ph-jordan/nima-tech/Configuração inicial da placa.pdf

## Guia de Configuração da Balança (ESP32)

Este procedimento deve ser realizado na primeira vez que a balança for ligada ou sempre que houver mudança na rede Wi-Fi ou no servidor MQTT.

### 1. Entrando no Modo de Configuração

Ao ligar a balança na energia, o sistema tentará conectar à última rede Wi-Fi salva. Se não conseguir conectar (ou se for a primeira vez), ela entrará automaticamente no Modo Seguro.

Verifique os displays LCD da balança. Se ela estiver aguardando configuração, aparecerá:

- LCD Principal: MODO SEGURO / WiFi: ESP-PESO
- LCD Secundário: Senha: Admin1234 / IP: 192.168.4.1

### 2. Conexão com o Dispositivo

O ESP32 criou uma rede Wi-Fi temporária para que você possa configurá-lo.

1. Pegue seu celular ou computador.
2. Abra as configurações de Wi-Fi.
3. Procure pela rede chamada: ESP32-Pesagem
4. Conecte-se a ela usando a senha: Admin1234

### 3. Acessando o Portal

Geralmente, assim que conectar, uma tela de login abrirá automaticamente (Captive Portal).

- Se a tela não abrir: Abra seu navegador (Chrome, Safari) e digite o endereço: 192.168.4.1

### 4. Configuração da Rede Wi-Fi

Na tela principal do portal:

1. Toque no botão "Configure WiFi".
2. Aguarde o escaneamento das redes.
3. Toque no nome da sua rede Wi-Fi (da empresa ou local de instalação).
4. No campo "Password" (logo no topo), digite a senha do seu Wi-Fi.

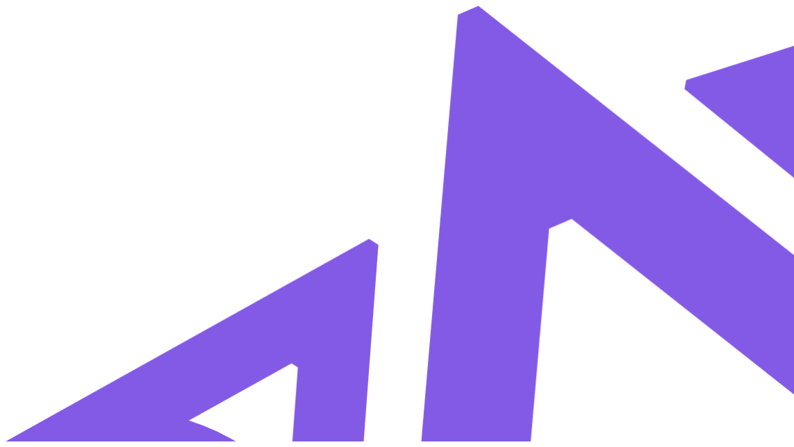
[picture p1: figure]

### 5. Configuração dos Parâmetros do Sistema

Abaixo dos campos de Wi-Fi, você verá os campos personalizados definidos no código. Preencha-os com atenção:

- Nome Bancada: Identificador local da balança (ex: Bancada_01, Setor_A). Isso será usado para identificar de onde vêm os dados.
- MQTT Broker: Endereço do servidor (6df66d562a2e4bbdb0555f70df83a04d.s1.eu.hivemq.cloud).
- MQTT Port: Porta do servidor (Padrão: 8883)
- MQTT User: Usuário de autenticação do broker. (Cliente)
- MQTT Pass: Senha do broker.(Placateste1).

### 6. Salvar e Finalizar

1. Revise se a senha do Wi-Fi e os dados do servidor estão corretos.
2. Clique no botão "Save".
3. A balança irá reiniciar automaticamente.
- Observe o LCD Principal: Ele deve mudar de "MODO SEGURO" para "INICIANDO..." e depois para o status de operação (ex: "Aguarde Cartão" ou "MQTT Conectado").
