ph-jordan/nima-tech/Empresas para realizarem outros serviços.pdf

### EMPRESAS PARA SERVIDOR BROKER:

- HiveMQ cloud;
- EMQX;
- MyQttHub;
- CloudMQTT;
- TagoIO;
- Ubidots;
- Big Tech;

### EMPRESAS QUE REALIZAM A MANUFATURA DA PLACA:

- Enterplak: https://enterplak.com.br/negocio/
- Mensagem da Enterplak: “Para garantirmos custos competitivos e repassarmos esses benefícios em nossas propostas comerciais, estabelecemos um faturamento mínimo de R$ 120.000,00 por pedido. Trabalhamos com pedidos menores, entre R$ 50.000,00 e R$ 120.000,00, porém com custos adicionais de setup.”
- Griffus:
https://www.griffuspcb.com.br/fabricacao-de-placas-de-circuito-impresso.html
- Global Eletronics: https://globaleletronics.ind.br/servicos/
- Cromatek:https://cromatek.com.br/montagem-de-placas-eletronicas/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 (https://cromatek.com.br/montagem-de-placas-eletronicas/?gad_source=1)
- Produza: https://produza.ind.br/
