ph-jordan/nima-tech/Lista de Materiais da placa com quantidade.odt

- ESP32 (com Wi-Fi e Bluetooth integrado) - modelo DEVKITC: QTD: 1 https://www.eletrogate.com/modulo-wifi-esp32-bluetooth-30-pinos
- Módulo Leitor de Cartões RFID – RC522: QTD: 1 https://www.eletrogate.com/kit-modulo-rfid-mfrc522-1356-mhz
- Conector placa/balança - Saída VGA – Max3232: QTD: 1 https://www.eletrogate.com/conversor-serial-rs232-ttl-max3232
- Botão - CHAVE BOTÃO S/TRAVA 2P: QTD: 5 https://www.saravati.com.br/botao-push-button-250vac-1a-2t-ds-213-sem-trava-preto.html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
- Telas - Display (LCD 16x2) I2C: QTD: 2 https://www.eletrogate.com/display-lcd-16x2-i2c-backlight-azul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
- Resistor 10K - 10 unidades: QTD: 5 https://www.eletrogate.com/resistor-10k-1-4w-10-unidades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
- Resistor 4.7K - 10 unidades: QTD: 2
  https://www.eletrogate.com/resistor-4k7-1-4w-10-unidades
- Resistor 5.1K - 10 unidades: QTD: 2 https://www.eletrogate.com/resistor-5k1-1-4w-10-unidades
- Resistor 330Ω - 10 unidades: QTD: 2 https://www.eletrogate.com/resistor-330r-1-4w-10-unidades
- Capacitor 0.1uF: QTD: 1 https://www.eletrogate.com/capacitor-eletrolitico-1uf-x-50v
- Capacitor Electrolítico SMD 10uF/25V: QTD: 1 https://www.eletrogate.com/capacitor-eletrolitico-10uf-x-50v
- Módulo regulador de tensão tipo C – GT-USB-7010ASV: QTD: 1
  https://pt.aliexpress.com/item/1005007205562231.html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,scm-url:1007.40050.354490.0,pvid:b62a1681-c8ce-4411-b673-8dc0f587e754,tpp_buckets:668%232846%238111%231996&isseo=y&pdp_ext_f=%7B%22order%22%3A%222%22%2C%22eval%22%3A%221%22%2C%22sceneId%22%3A%2230050%22%2C%22fromPage%22%3A%22recommend%22%7D&pdp_npi=6%40dis%21BRL%212.59%212.46%21%21%213.19%213.03%21%402101e80f17648797563131982e8ef2%2112000039798651333%21rec%21BR%21%21ABX%211%210%21n_tag%3A-29910%3Bd%3A8ee5d72e%3Bm03_new_user%3A-29895&utparam-url=scene%3ApcDetailTopMoreOtherSeller%7Cquery_from%3A%7Cx_object_id%3A1005007205562231%7C_p_origin_prod%3A
- Diodo tvs - modelo “TT0521SB”: QTD: 1 https://www.acheicomponentes.com.br/diodo/kit-5-pecas-diodo-tt0521sb-smd-sod-882-5v-40a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
- Led verde – 3mm: QTD: 1 https://www.eletrogate.com/led-difuso-3mm-verde
- Led vermelho – 3mm: QTD: 1 https://www.eletrogate.com/led-difuso-3mm-vermelho
