ph-jordan/nima-tech/Lista de Materiais.pdf

- ESP32 (com Wi-Fi e Bluetooth integrado) - modelo DEVKITC: https://pt.aliexpress.com/item/1005006651936701.html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,scm-url :1007.40196.366991.0,pvid:86ee71ca-66aa-47d0-9b59-c49c89f24ca9,tpp_buckets:668 %232846%238116%232002&pdp_ext_f=%7B%22order%22%3A%22409%22%2C%22e val%22%3A%221%22%2C%22sceneId%22%3A%2230050%22%7D&pdp_npi=4%40di s%21BRL%2127.27%2117.27%21%21%214.50%212.85%21%402101c8021741474912 8488895e673c%2112000037929819276%21rec%21BR%21%21ABXZ&utparam-url=sc ene%3ApcDetailTopMoreOtherSeller%7Cquery_from%3A (https://pt.aliexpress.com/item/1005006651936701.html?scm_id=1007.40196.366991.0&scm-url=1007.40196.366991.0)
- Botão - CHAVE BOTÃO S/TRAVA 2P: https://www.saravati.com.br/botao-push-button-250vac-1a-2t-ds-213-sem-trava-preto.html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 cB (https://www.saravati.com.br/botao-push-button-250vac-1a-2t-ds-213-sem-trava-preto.html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)
- Módulo Leitor de Cartões RFID - RC522: https://produto.mercadolivre.com.br/MLB-814816014-kit-modulo-leitor-rfid-mfrc522-mifare-_JM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 (https://produto.mercadolivre.com.br/MLB-814816014-kit-modulo-leitor-rfid-mfrc522-mifare-_JM?variation=)
- Telas - Display (LCD 16x2) I2C: https://www.eletrogate.com/display-lcd-16x2-i2c-backlight-azul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 (https://www.eletrogate.com/display-lcd-16x2-i2c-backlight-azul?gad_source=4&gad_campaignid=22470016551)
- Conector placa/balança - Saída VGA - Max3232: https://www.mercadolivre.com.br/conversor-rs232-ttl-max3232-serial-db9-femea-arduino-nodemcu/p/MLB32810743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 (https://www.mercadolivre.com.br/conversor-rs232-ttl-max3232-serial-db9-femea-arduino-nodemcu/p/MLB32810743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)
- Resistor 10K - 10 unidades: https://www.eletrogate.com/resistor-10k-1-4w-10-unidades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 (https://www.eletrogate.com/resistor-10k-1-4w-10-unidades?gad_source=1&gad_campaignid=22470016551)


- Resistor 4.7K - 10 unidades: https://www.eletrogate.com/resistor-4k7-1-4w-10-unidades
- Resistor 5.1K - 10 unidades: https://www.eletrogate.com/resistor-5k1-1-4w-10-unidades
- Resistor 330Ω - 10 unidades: https://www.eletrogate.com/resistor-330r-1-4w-10-unidades
- Capacitor 0.1uF:
https://www.eletrogate.com/capacitor-eletrolitico-1uf-x-50v
- Capacitor Electrolítico SMD 10uF/25V: https://www.eletrogate.com/capacitor-eletrolitico-10uf-x-50v
- Módulo regulador de tensão tipo C - GT-USB-7010ASV: https://pt.aliexpress.com/item/1005007205562231.html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,scm-url: 1007.40050.354490.0,pvid:b62a1681-c8ce-4411-b673-8dc0f587e754,tpp_buckets:668% 232846%238111%231996&isseo=y&pdp_ext_f=%7B"order"%3A"2"%2C"eval"%3A"1"% 2C"sceneId"%3A"30050"%2C"fromPage"%3A"recommend"%7D&pdp_npi=6%40dis%21 BRL%212.59%212.46%21%21%213.19%213.03%21%402101e80f1764879756313198 2e8ef2%2112000039798651333%21rec%21BR%21%21ABX%211%210%21n_tag%3A-29910%3Bd%3A8ee5d72e%3Bm03_new_user%3A-29895&utparam-url=scene%3ApcD etailTopMoreOtherSeller%7Cquery_from%3A%7Cx_object_id%3A1005007205562231% 7C_p_origin_prod%3A (https://pt.aliexpress.com/item/1005007205562231.html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)
- Diodo tvs - modelo “TT0521SB”: https://www.acheicomponentes.com.br/diodo/kit-5-pecas-diodo-tt0521sb-smd-sod-882-5v-40a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 (https://www.acheicomponentes.com.br/diodo/kit-5-pecas-diodo-tt0521sb-smd-sod-882-5v-40a?parceiro=3811)
- Led verde - 3mm:
https://www.eletrogate.com/led-difuso-3mm-verde
- Led vermelho - 3mm:
https://www.eletrogate.com/led-difuso-3mm-vermelho
