ph-jordan/nima-tech/Schematic_PCI-Balança-2_2025-11-14 (2).pdf

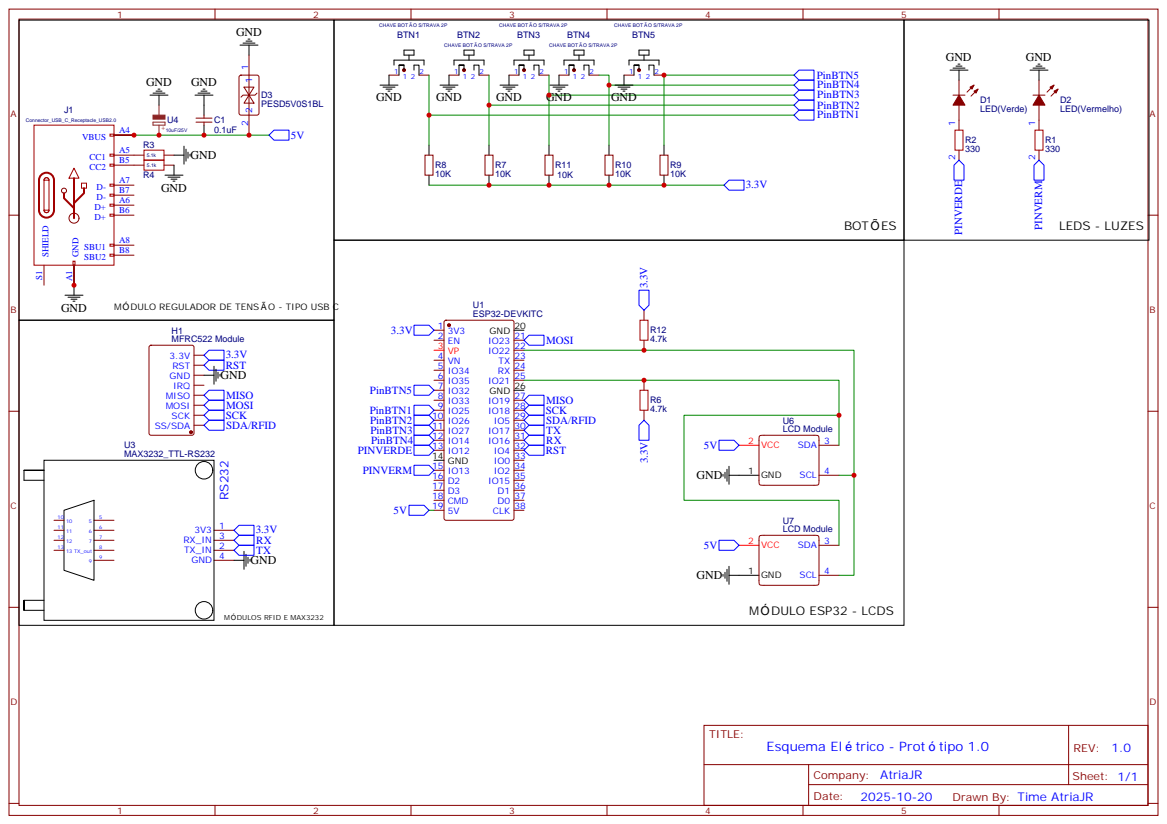
[picture p13: page 1]

M DULO REGULADOR DE TENS O - TIPO USB C

Drawn By: Time AtriaJR
