ph-jordan/nima-tech/(list of files, drawings)

Other design files:
Bibliotecas/MFRC522/doc/fritzing/Arduino-Uno-r3-with-RFID-RC522.fzz
