ph-jordan/nima-tech/(commit log)

2026-10-07 Adiciona projeto ESP32 de pesagem
    [Arduino-Uno-r3-with-RFID-RC522.fzz]
2026-10-07 Adiciona backend Supabase para pesagem
